klownfish/rocket1/img/cone.jpg

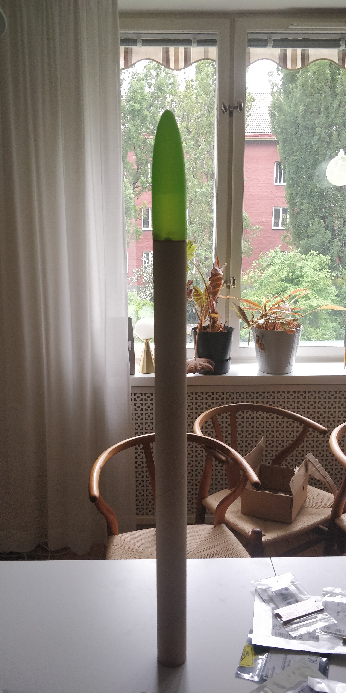
img/cone.jpg
