klownfish/rocket1/body/fc_mount.stl

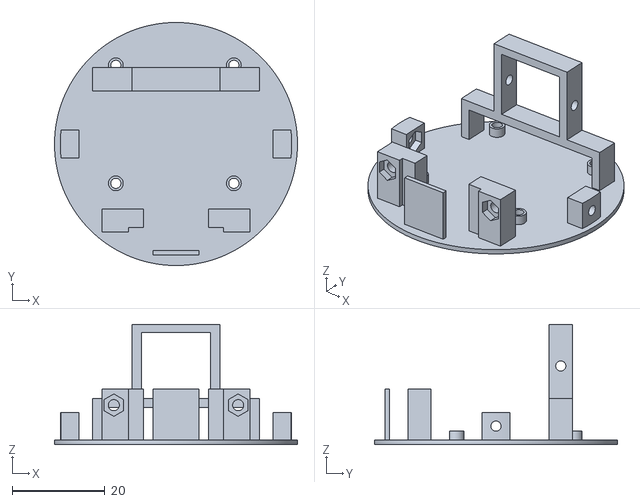
[picture p7: CAD file, 2021-11-23]
body/fc_mount.stl
52.5 x 52.5 x 26.0
