klownfish/rocket1/body/hanger.stl

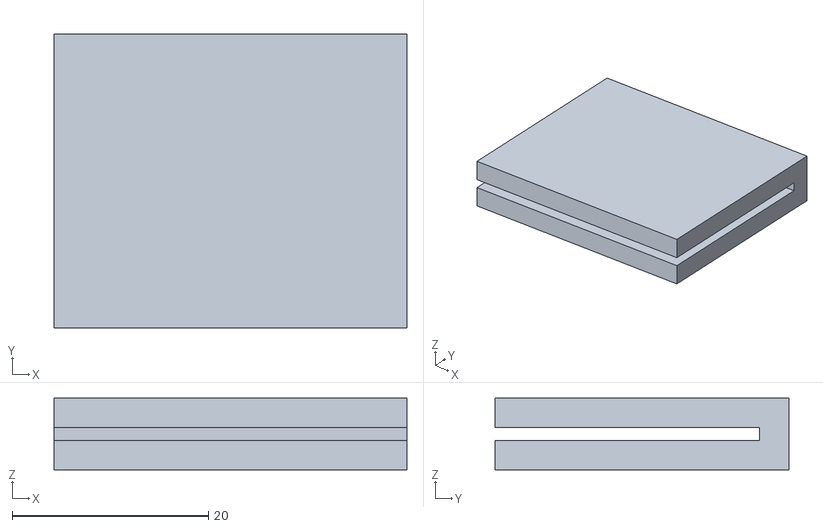
[picture p8: CAD file, 2021-11-23]
body/hanger.stl
36.0 x 30.0 x 7.30
