klownfish/rocket1/body/engine_mount.stl

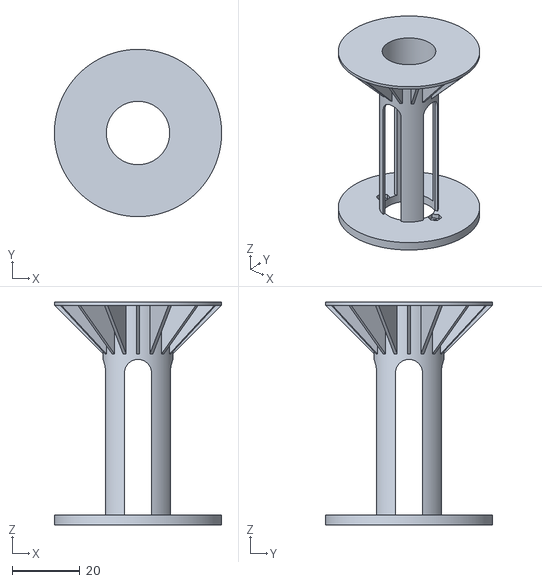
[picture p9: CAD file, 2021-11-23]
body/engine_mount.stl
49.5 x 49.5 x 66.0
