klownfish/rocket1/body/external_mount.stl

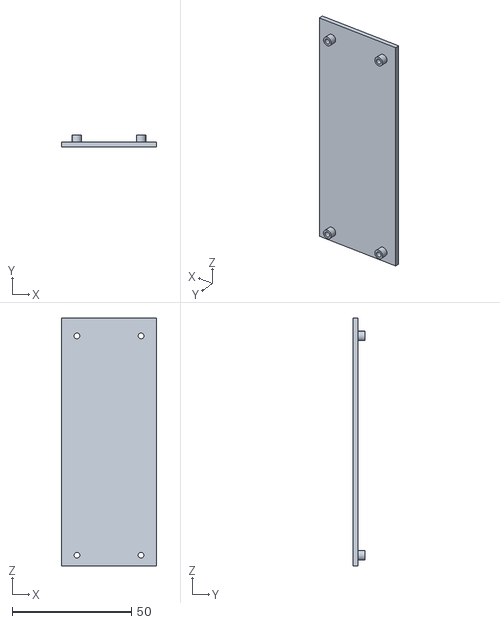
[picture p10: CAD file, 2021-11-23]
body/external_mount.stl
40.0 x 5.00 x 104.0
