klownfish/rocket1/body/external_mount_poles.stl

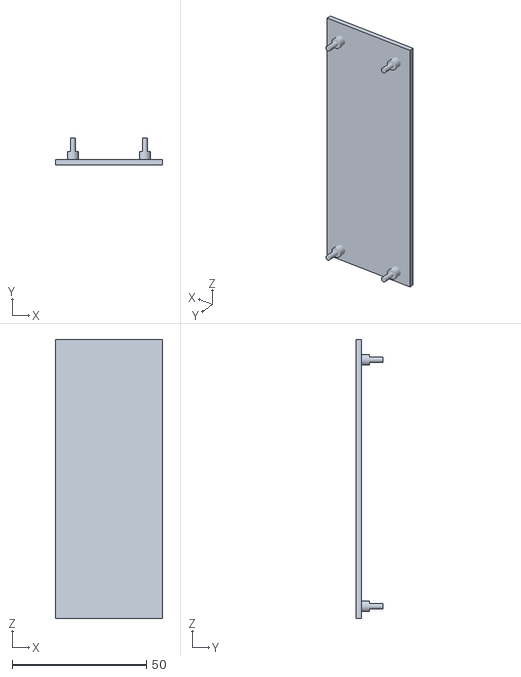
[picture p11: CAD file, 2021-11-23]
body/external_mount_poles.stl
40.0 x 10.0 x 104.0
