klownfish/rocket1/body/adapter.stl

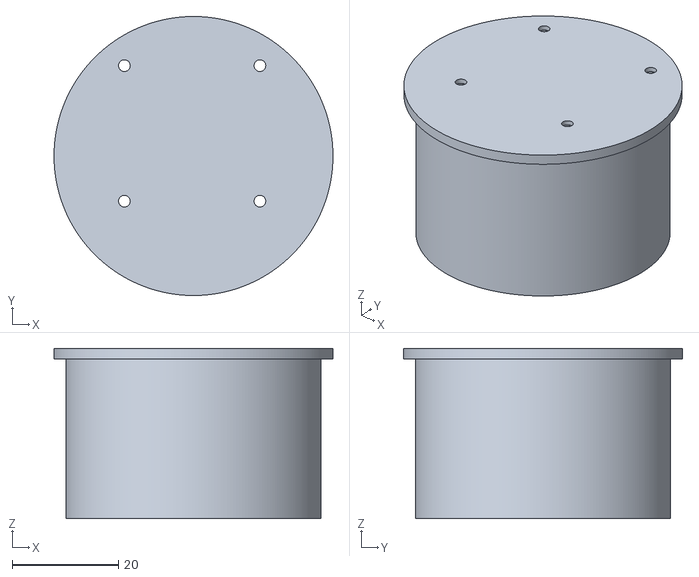
[picture p12: CAD file, 2021-08-26]
body/adapter.stl
52.5 x 52.5 x 32.0
