klownfish/rocket1/body/everything.stl

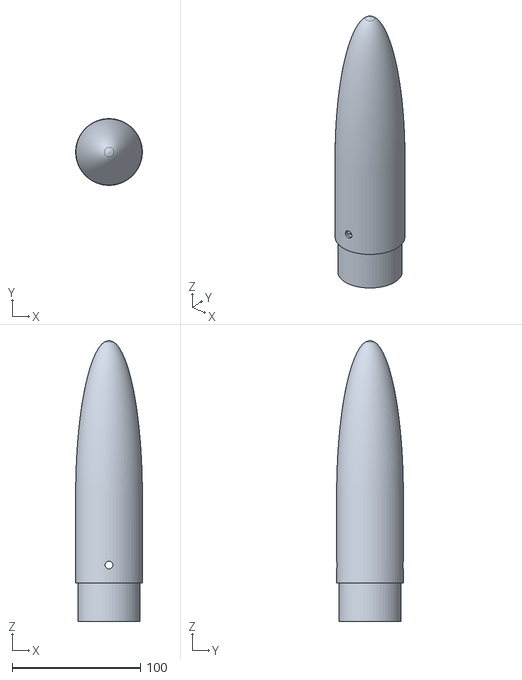
[picture p13: CAD file, 2021-08-14]
body/everything.stl
52.0 x 52.0 x 219.0
