klownfish/rocket1/body/baffle.stl

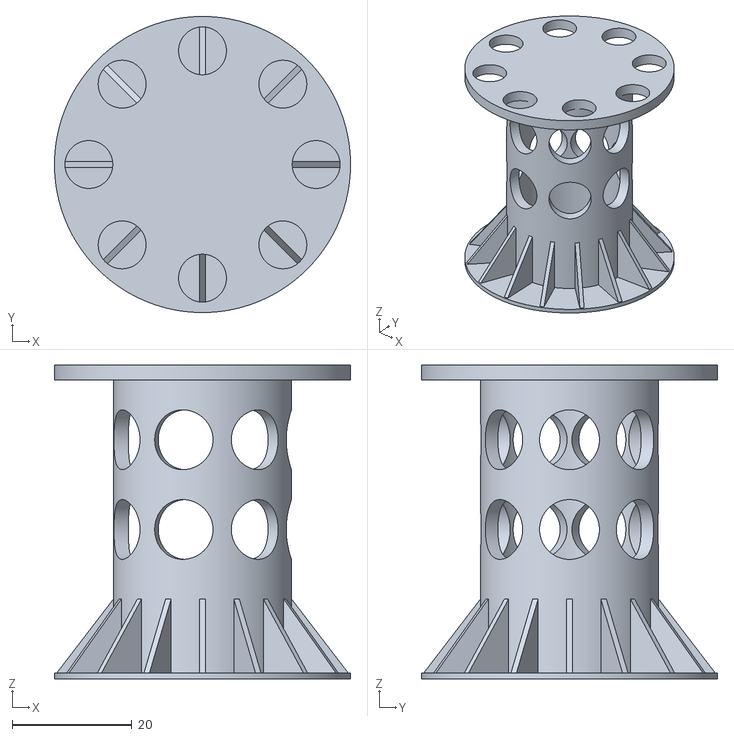
[picture p14: CAD file, 2021-08-14]
body/baffle.stl
49.5 x 49.5 x 52.5
