klownfish/rocket1/body/engine_mount_top.stl

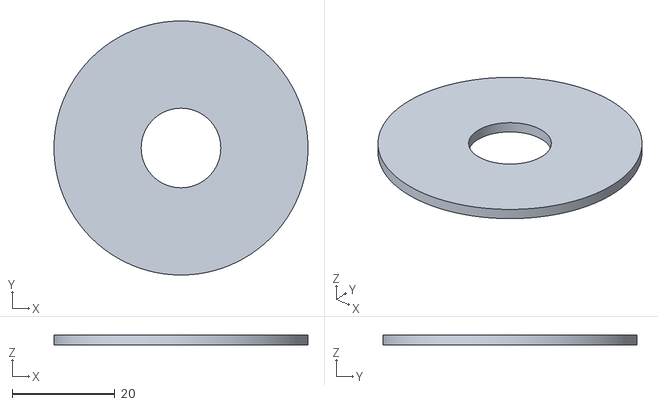
[picture p15: CAD file, 2021-08-14]
body/engine_mount_top.stl
49.5 x 49.5 x 2.00
