klownfish/rocket1/body/separator.stl

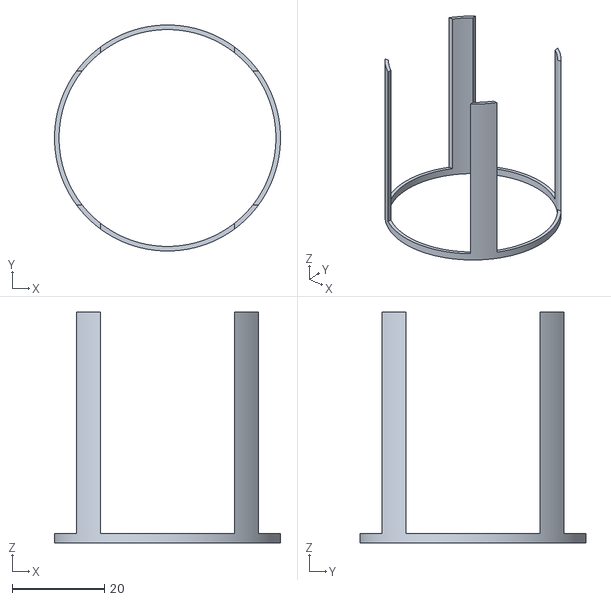
[picture p16: CAD file, 2021-08-14]
body/separator.stl
49.0 x 49.0 x 50.0
