klownfish/rocket1/body/launch_lug.stl

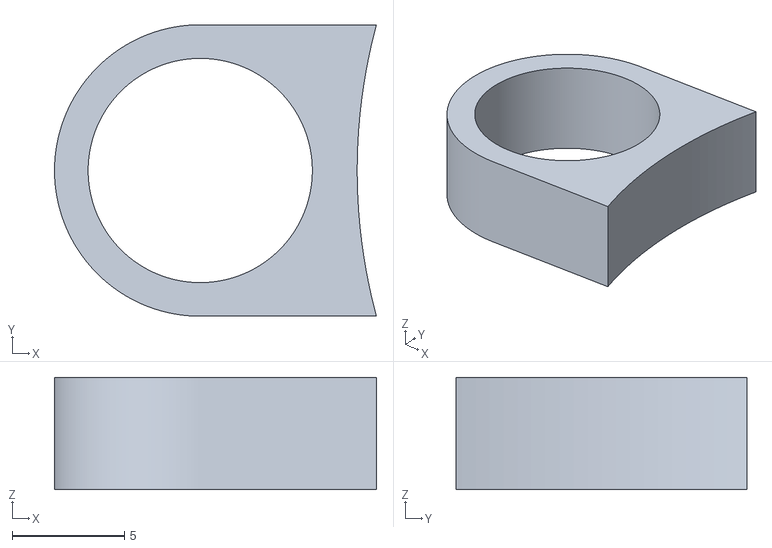
[picture p17: CAD file, 2021-08-14]
body/launch_lug.stl
14.4 x 13.0 x 5.00
