klownfish/rocket1/body/fin_support.stl

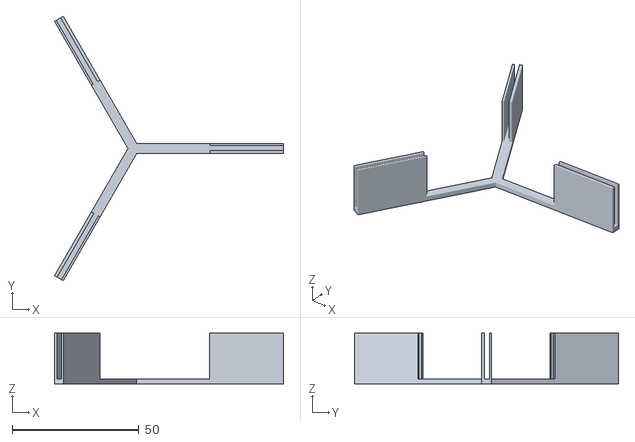
[picture p18: CAD file, 2021-08-14]
body/fin_support.stl
90.2 x 104.2 x 20.0
