klownfish/rocket1/body/shock_cord_holder.stl

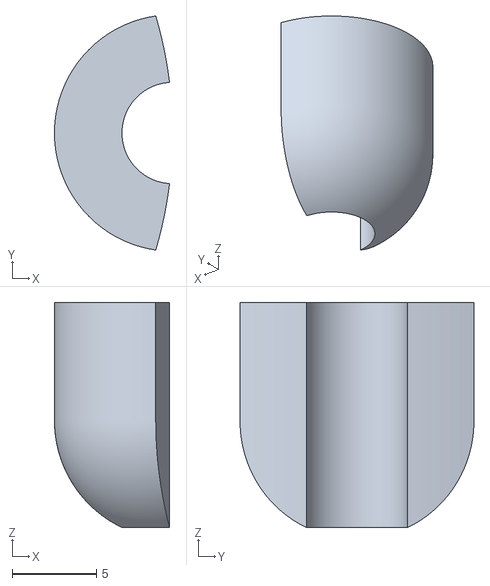
[picture p19: CAD file, 2021-08-14]
body/shock_cord_holder.stl
6.82 x 13.9 x 13.3
