klownfish/rocket1/body/fins.stl

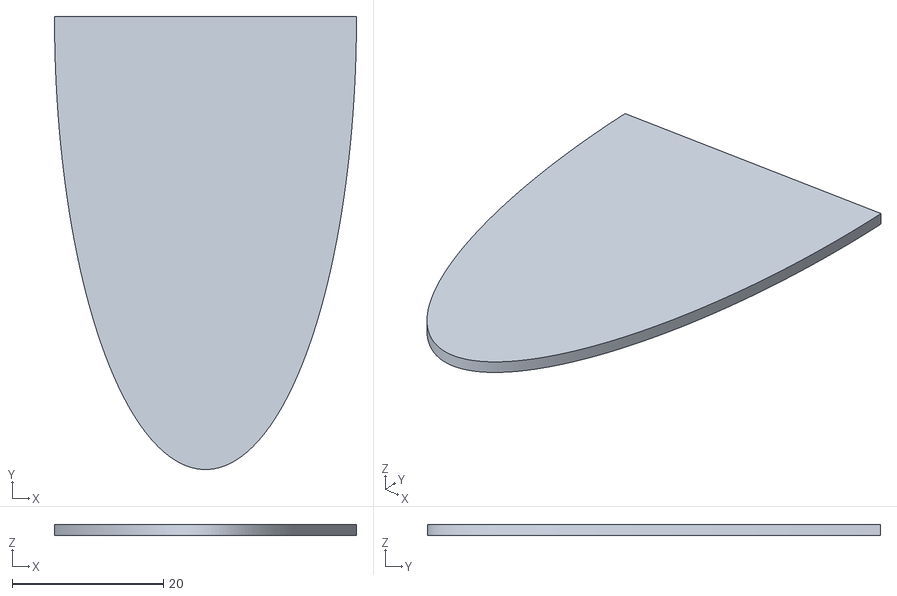
[picture p20: CAD file, 2021-08-14]
body/fins.stl
40.0 x 60.0 x 1.50
