klownfish/rocket1/body/engine_spacer.stl

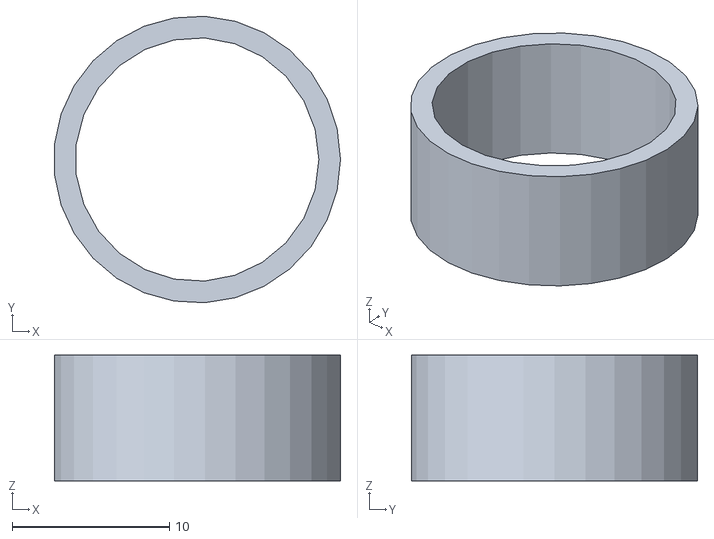
[picture p21: CAD file, 2021-08-14]
body/engine_spacer.stl
18.2 x 18.2 x 8.00
