klownfish/rocket1/electronics/project.kicad_pcb

## KiCad design electronics/project.kicad_pcb (2021-05-12)

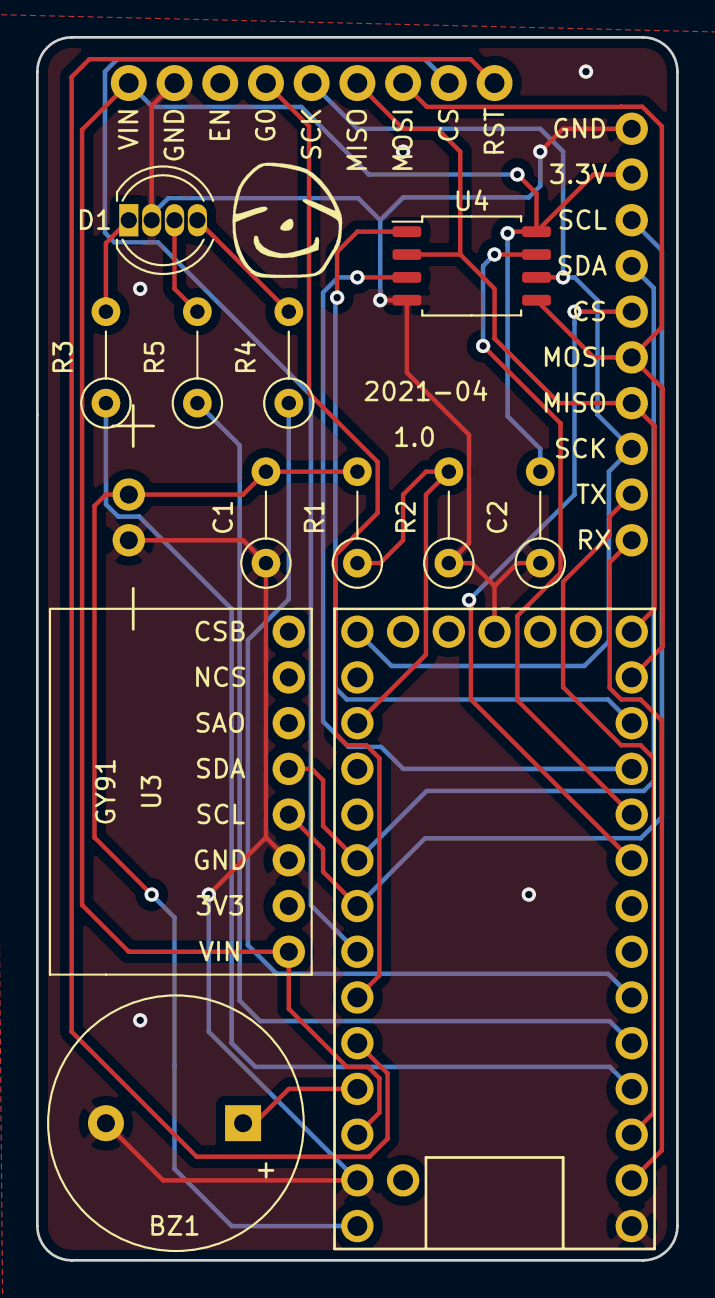
[picture p22: board project.kicad_pcb from above]

Board: 2 copper layers, 35.6 x 67.9 mm, 15 parts (0 on the bottom side), 25 nets.

Parts:
BAT1: terminal-2; terminal-small
BZ1: Buzzer; buzzer
C1: 100nF; R_Axial_DIN0207_L6.3mm_D2.5mm_P5.08mm_Vertical
C2: 22pF; R_Axial_DIN0207_L6.3mm_D2.5mm_P5.08mm_Vertical
D1: LED_RGBC; LED_D5.0mm-4_RGB
J1: Conn_01x10; 01x10_header
R1, R2: 500k; R_Axial_DIN0207_L6.3mm_D2.5mm_P5.08mm_Vertical
R3, R4, R5: R; R_Axial_DIN0207_L6.3mm_D2.5mm_P5.08mm_Vertical
U1: Teensy 4.0; teensy4
U2: RFM69HCW; Adafruit-RFM69
U3: GY91
U4: W25Q128JV; SOIC-8_5.275x5.275mm_P1.27mm

Connections:
3V3: C2.2, J1.2, U1.31, U2.1, U3.1, U4.8
/BUZZ: BZ1.1, U1.30
/EXT-CS: J1.5, U1.9
/FLASH-CS: U1.12, U4.1
/FLASH-HOLD: U1.10, U4.7
/FLASH-WP: U1.11, U4.3
/LED-B: R4.1, U1.6
/LED-G: R5.1, U1.5
/LED-R: R3.1, U1.4
/MISO: J1.7, U1.14, U2.6, U4.2
/MOSI: J1.6, U1.13, U2.7, U4.5
/RF-CS: U1.27, U2.8
/RF-G0: U1.28, U2.4
/RF-RST: U1.29, U2.9
/RX1: J1.10, U1.2
/SCK: J1.8, U1.20, U2.5, U4.6
/SCL: J1.3, U1.26, U3.4
/SDA: J1.4, U1.25, U3.5
/TX1: J1.9, U1.3
/bat_read: R1.1, R2.2, U1.22
GND: BAT1.1, BZ1.2, C1.1, C2.1, D1.4, J1.1, R2.1, U1.1, U1.17, U1.32, U2.2, U3.3, U4.4
unnamed: D1.1, R3.2
unnamed: D1.2, R5.2
unnamed: D1.3, R4.2
VIN: BAT1.2, C1.2, R1.2, U1.33
