klownfish/rocket1/(commit log)

2021-01-03 add schematic
    [project.kicad_pcb, project.sch]
2021-01-04 W.I.P software
    [project.sch]
2021-01-04 first draft of controller and gateway
    [project.sch]
2021-01-14 update protocol and schematics
    [project.sch]
2021-05-12 new flight controller tested
    [components.ods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]
2021-05-29 W.I.P pcb v2
    [components.ods, fc_v2.kicad_pcb, fc_v2.sch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]
2021-05-30 PCB mostly finished
    [components.ods, fc_v2.kicad_pcb, fc_v2.sch, project.kicad_pcb, project.sch]
2021-06-05 fixes on PCB
    [aesir.kicad_pcb, aesir.sch, components.ods, fc_v2.kicad_pcb, fc_v2.sch]
2021-06-06 fix P-EN
    [components.ods, fc_v2.kicad_pcb, fc_v2.sch]
2021-06-18 main fc traces done
    [fc_v2.kicad_pcb, fc_v2.sch, main_v1.kicad_pcb, main_v1.sch]
2021-08-14 pre routing mini controller
    [adapter.stl, baffle.scad, baffle.stl, components.ods, engine_mount.scad, engine_mount.stl, engine_mount_top.scad, engine_mount_top.stl]
2021-08-16 pre U.FL version
    [components.ods, mini_controller.dsn, mini_controller.kicad_pcb, mini_controller.sch, nose.scad]
2021-08-17 mini controller finished
    [components.ods, mini_controller.kicad_pcb, mini_controller.sch]
2021-08-26 layout for revision 4
    [adapter.stl, components.ods, mini_controller.dsn, mini_controller.kicad_pcb, mini_controller.sch, mini_controller.stl, nose.scad]
2021-08-28 routing finished v4
    [mini_controller.dsn, mini_controller.kicad_pcb, mini_controller.sch, mini_controller.stl]
2021-11-28 restructure and README
    [aesir.kicad_pcb, aesir.sch, components.ods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]
